Hoanghust23/-A-variable-leglength-bipedal-wheeled-robot-using-a-combined-LQR-Fuzzy-control-approach/README.md

## 📺 Video vận hành thực tế
<div align="center">
  <a href="https://www.youtube.com/watch?v=GrfQsvZkNRI">
    WBR Robot Balancing Demo
  </a>
  <br>
  <b>Nhấn vào hình ảnh trên để xem video demo trên YouTube</b>
</div>
