Hoanghust23/-A-variable-leglength-bipedal-wheeled-robot-using-a-combined-LQR-Fuzzy-control-approach/Gazebo/src/meshes/right_wheel.STL

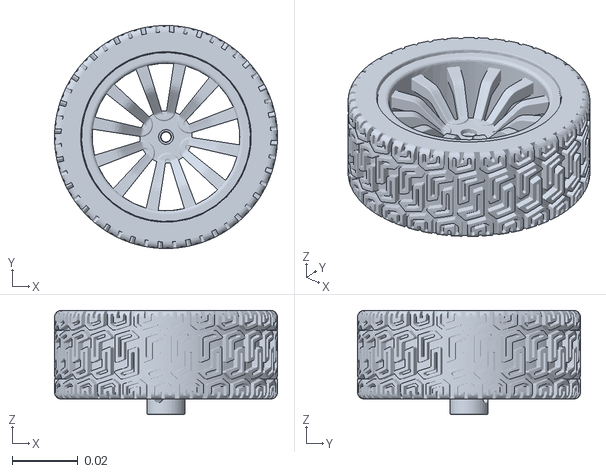
[picture p41: CAD file, 2026-03-11]
Gazebo/src/meshes/right_wheel.STL
0.068 x 0.068 x 0.0317
