Hoanghust23/-A-variable-leglength-bipedal-wheeled-robot-using-a-combined-LQR-Fuzzy-control-approach/Hardware/Leg_Up_Front.SLDPRT

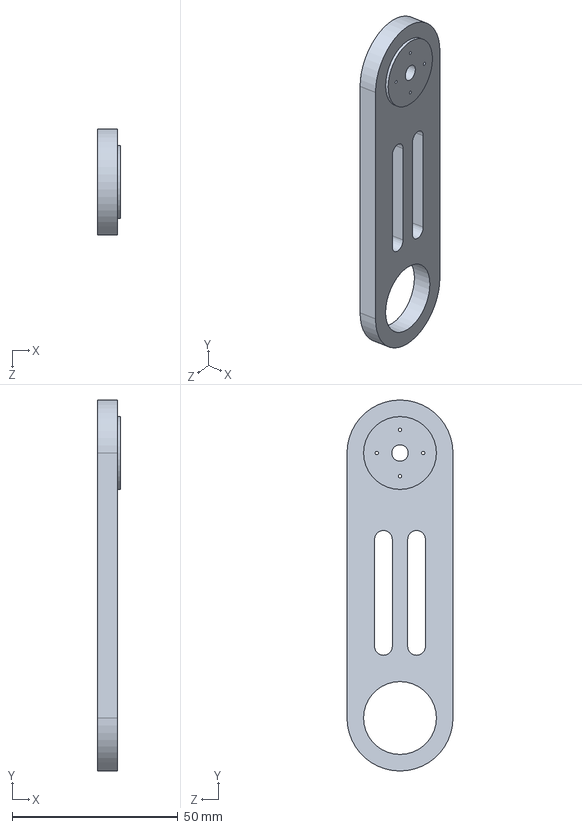
[picture p42: CAD file, 2026-03-11]
Hardware/Leg_Up_Front.SLDPRT
7.00 x 112.0 x 32.0 mm
