Hoanghust23/-A-variable-leglength-bipedal-wheeled-robot-using-a-combined-LQR-Fuzzy-control-approach/Gazebo/src/meshes/base_link.STL

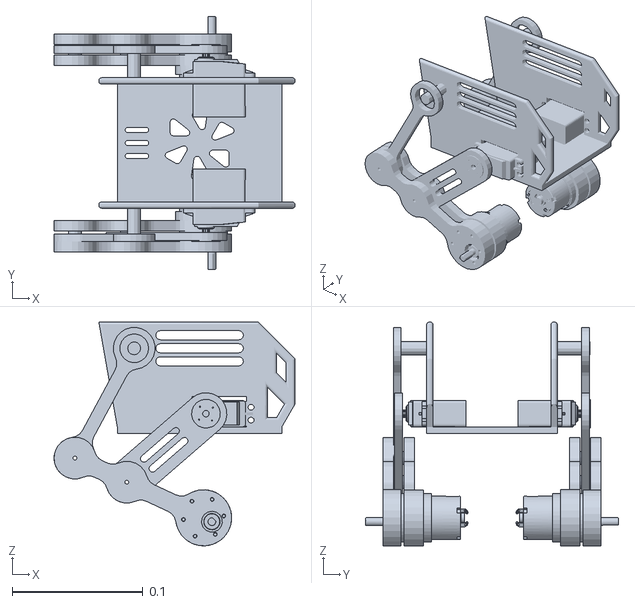
[picture p43: CAD file, 2026-03-11]
Gazebo/src/meshes/base_link.STL
0.184 x 0.194 x 0.171
