Hoanghust23/-A-variable-leglength-bipedal-wheeled-robot-using-a-combined-LQR-Fuzzy-control-approach/Hardware/Leg_Down.SLDPRT

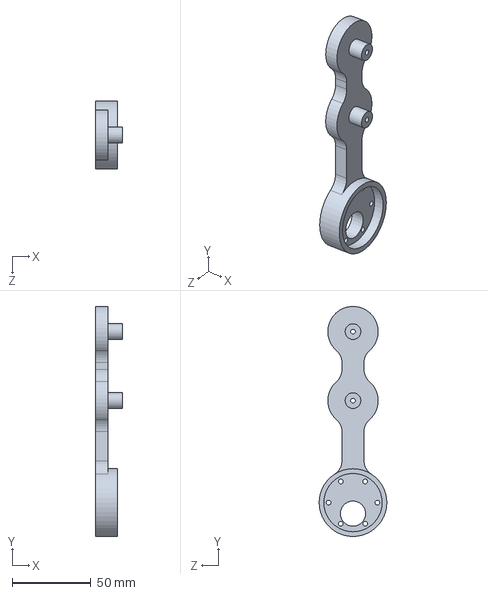
[picture p44: CAD file, 2026-03-11]
Hardware/Leg_Down.SLDPRT
17.0 x 145.9 x 43.0 mm
