Hoanghust23/-A-variable-leglength-bipedal-wheeled-robot-using-a-combined-LQR-Fuzzy-control-approach/Hardware/head.SLDPRT

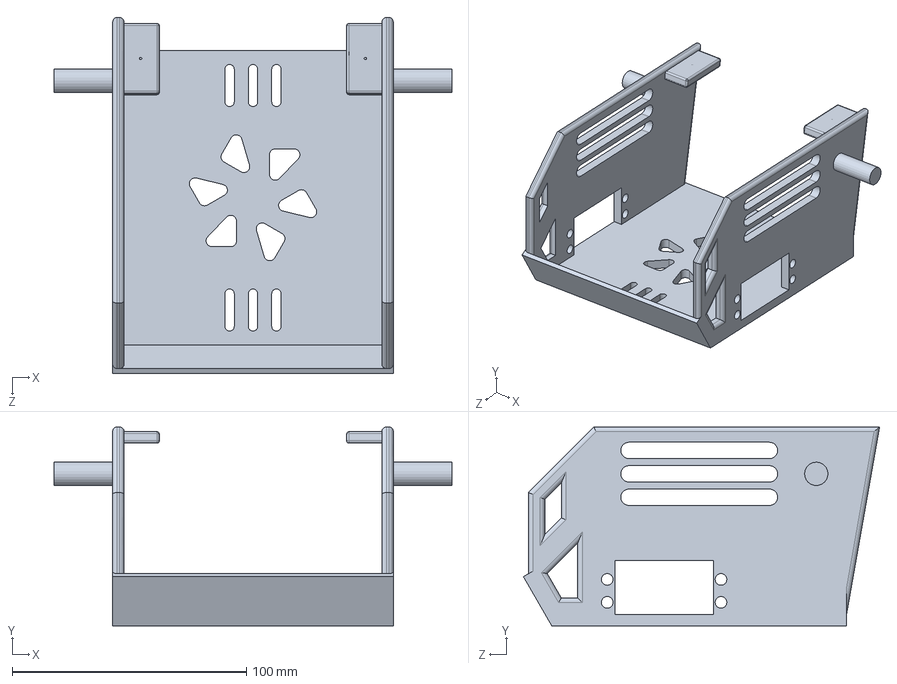
[picture p45: CAD file, 2026-03-11]
Hardware/head.SLDPRT
170.0 x 85.0 x 152.2 mm
