Hoanghust23/-A-variable-leglength-bipedal-wheeled-robot-using-a-combined-LQR-Fuzzy-control-approach/Hardware/Leg_Up_Back.SLDPRT

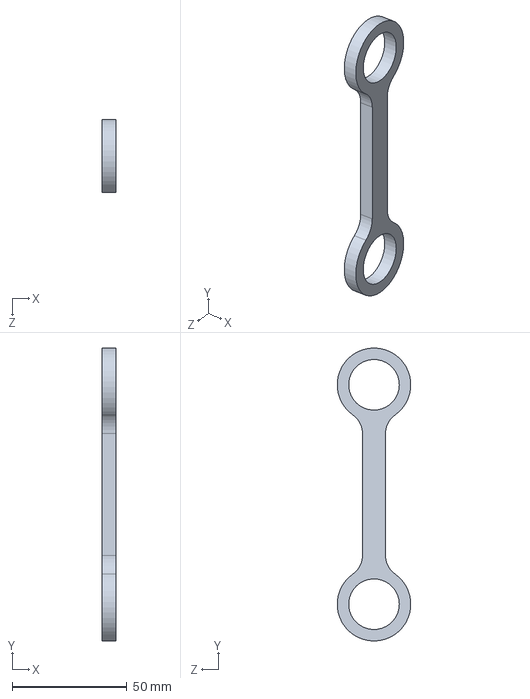
[picture p46: CAD file, 2026-03-11]
Hardware/Leg_Up_Back.SLDPRT
6.00 x 127.4 x 31.9 mm
