Hoanghust23/-A-variable-leglength-bipedal-wheeled-robot-using-a-combined-LQR-Fuzzy-control-approach/Hardware/Leg_Down - Copy.SLDPRT

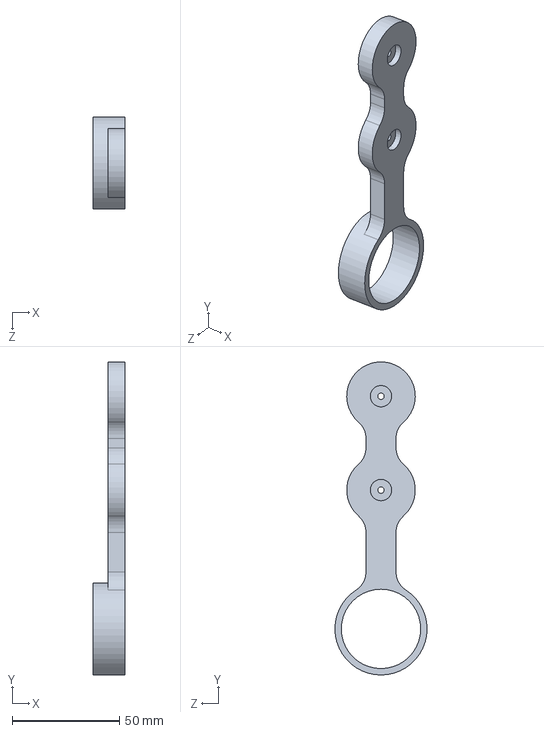
[picture p47: CAD file, 2026-03-11, an earlier design]
Hardware/Leg_Down - Copy.SLDPRT
15.0 x 145.9 x 43.0 mm
