Hoanghust23/-A-variable-leglength-bipedal-wheeled-robot-using-a-combined-LQR-Fuzzy-control-approach/(list of files, cad)

Other CAD files:
Gazebo/src/meshes/left_wheel.STL
