Hoanghust23/-A-variable-leglength-bipedal-wheeled-robot-using-a-combined-LQR-Fuzzy-control-approach/Gazebo/src/config/controllers.yaml

# Joint State Controller
joint_state_controller:
  type: joint_state_controller/JointStateController
  publish_rate: 50

# Wheel Velocity Controllers
right_wheel_velocity_controller:
  type: velocity_controllers/JointVelocityController
  joint: right_wheel_joint
  pid: {p: 1.0, i: 0.1, d: 0.0}

left_wheel_velocity_controller:
  type: velocity_controllers/JointVelocityController
  joint: left_wheel_joint
  pid: {p: 1.0, i: 0.1, d: 0.0}
